grbman/christmas-ornament/hw/reworks.md

## Reworks  
- Install 0 ohm between "south" sides of R7 and R8
- Install 82pF cap at C3 and C4
- Install magnet wire from R18 east pad to R9 north pad
