grbman/christmas-ornament/hw/christmas_ornament.pdf

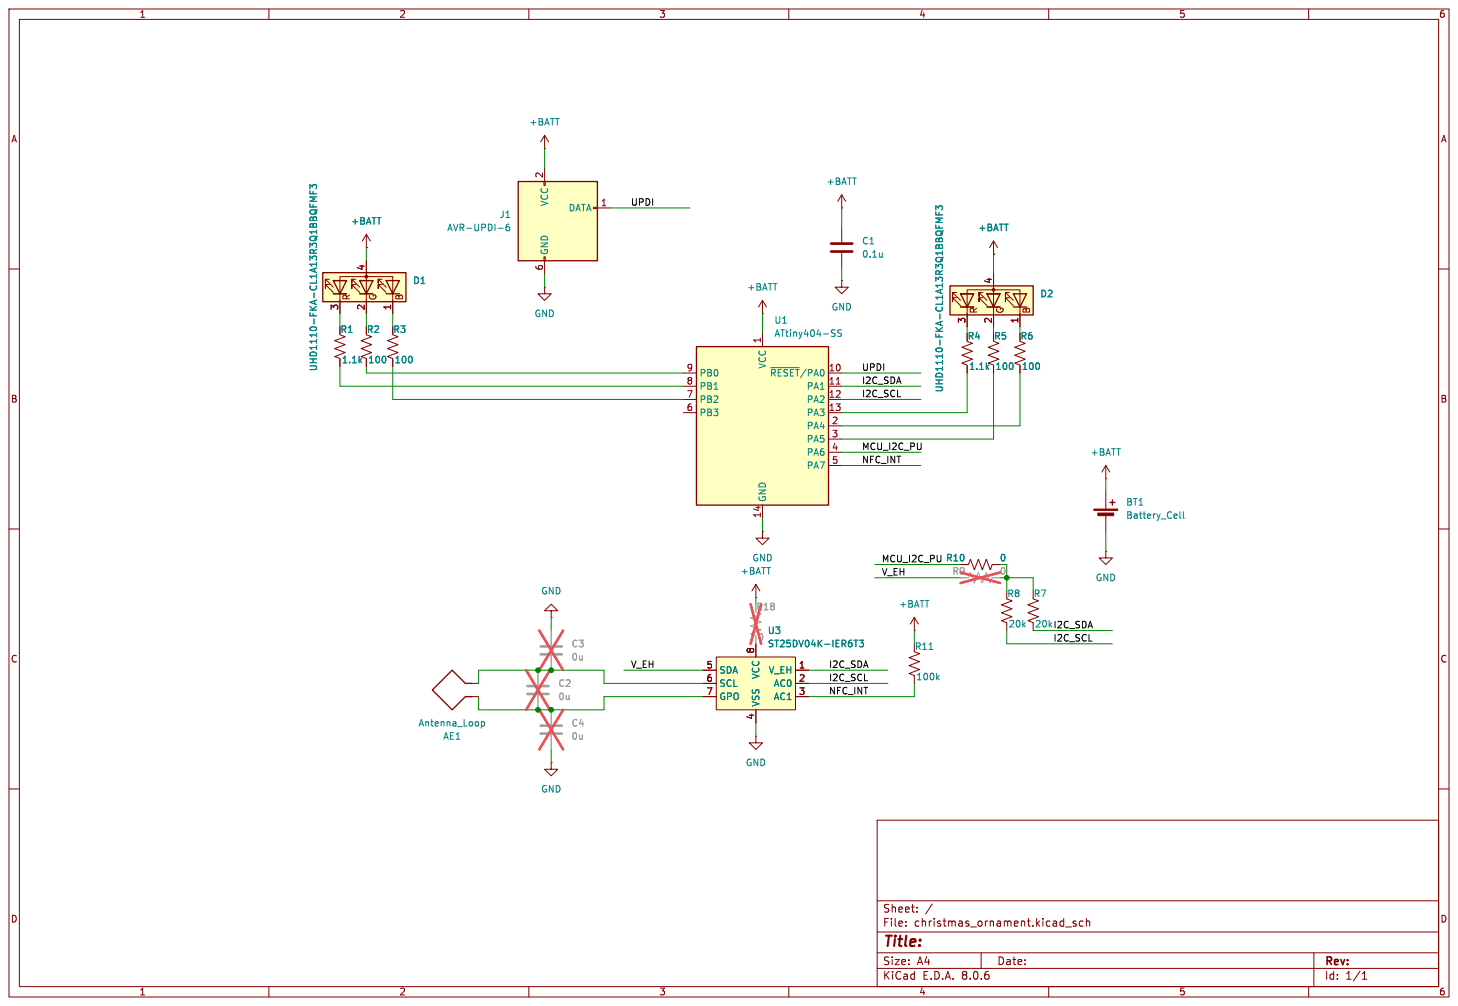
[picture p1: page 1]
