grbman/christmas-ornament/hw/christmas_ornament.kicad_pcb

## KiCad design hw/christmas_ornament.kicad_pcb (2024-11-28)

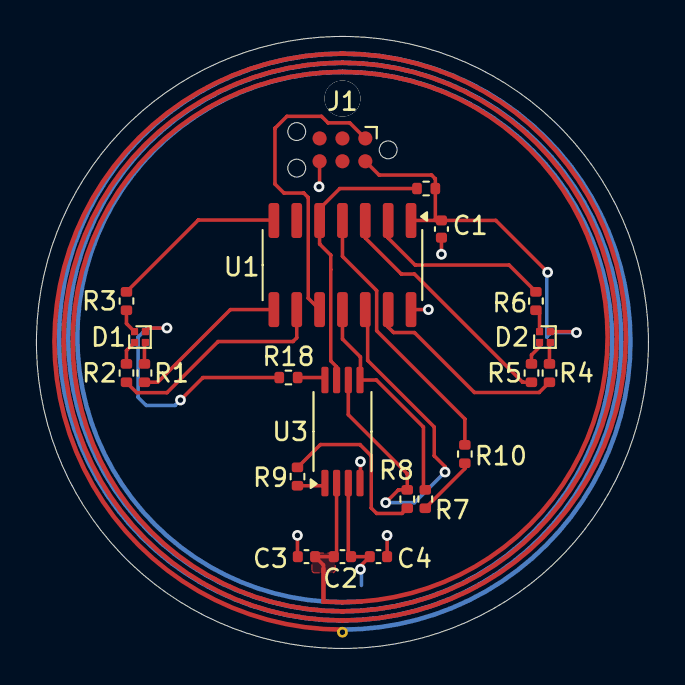
[picture p2: board christmas_ornament.kicad_pcb from above]

Board: 2 copper layers, 34.0 x 34.0 mm, 23 parts (1 on the bottom side), 24 nets.

Parts:
AE1: Antenna_Loop; NFC_coil
BT1: Battery_Cell; BH-67D-5
C1: 0.1u; C_0402_1005Metric
C2, C3, C4: 0u; C_0402_1005Metric
D1, D2: UHD1110-FKA-CL1A13R3Q1BBQFMF3
J1: AVR-UPDI-6; Tag-Connect_TC2030-IDC-NL_2x03_P1.27mm_Vertical
R1, R4: 1.1k; R_0402_1005Metric
R2, R3, R5, R6: 100; R_0402_1005Metric
R7, R8: 20k; R_0402_1005Metric
R9, R10, R18: 0; R_0402_1005Metric
R11: 100k; R_0402_1005Metric
U1: ATtiny404-SS; SOIC-14_3.9x8.7mm_P1.27mm
U3: ST25DV04K-IER8C3; TSSOP-8_4.4x3mm_P0.65mm

Connections:
+BATT: BT1.1 (+), C1.1, D1.4 (A), D2.4 (A), J1.2 (VCC), R11.1, R18.1, U1.1 (VCC)
/I2C_SCL: R8.2, U1.12 (PA2), U3.6 (SCL)
/I2C_SDA: R7.2, U1.11 (PA1), U3.5 (SDA)
/MCU_I2C_PU: R10.1, U1.4 (PA6)
/NFC_INT: R11.2, U1.5 (PA7), U3.7 (GPO)
/UPDI: J1.1 (DATA), U1.10 (~RESET/PA0)
/V_EH: R9.1, U3.1 (V_EH)
GND: BT1.2 (-), C1.2, C3.1, C4.2, J1.6 (GND), U1.14 (GND), U3.4 (VSS)
unnamed: D1.1 (BK), R3.1
unnamed: D1.2 (GK), R2.1
unnamed: D1.3 (RK), R1.1
unnamed: D2.1 (BK), R6.1
unnamed: D2.2 (GK), R5.1
unnamed: D2.3 (RK), R4.1
unnamed: R7.1, R8.1, R9.2, R10.2
unnamed: R4.2, U1.13 (PA3)
unnamed: R6.2, U1.2 (PA4)
unnamed: R5.2, U1.3 (PA5)
unnamed: R2.2, U1.9 (PB0)
unnamed: R1.2, U1.8 (PB1)
unnamed: R3.2, U1.7 (PB2)
unnamed: AE1.1, C2.1, C3.2, U3.2 (AC0)
unnamed: AE1.2, C2.2, C4.1, U3.3 (AC1)
unnamed: R18.2, U3.8 (VCC)
