grbman/christmas-ornament/fw/src/main.c

#define F_CPU 32768
// #include <avr/iotn404.h>
#include <avr/io.h>
#include <util/delay.h>
#include <stdio.h>
#include <avr/interrupt.h>
#include <stddef.h>
#include <stdbool.h>
#include "pindefs.h"
#include "updi_stdio.h"
#include "led.h"
#include "i2c_bitbang.h"
#include "nfc.h"

void (*leds_next)();
volatile bool nfc_write_flag = false;

int main()
{
    // clk setup
    // unlock clock regs
    // use 32768kHz oscillator, no clk output
    CPU_CCP = CCP_IOREG_gc;
    CLKCTRL.MCLKCTRLA = CLKCTRL_CLKSEL_OSCULP32K_gc;
    CPU_CCP = CCP_IOREG_gc;
    CLKCTRL.MCLKCTRLB = 0;

    /* set default GPIO direction to input */
    PORTA.DIR = 0;
    PORTB.DIR = 0;

    /* enable falling edge interrupt */
    PORTA.PIN7CTRL |= PORT_ISC_FALLING_gc;
    PORTA.INTFLAGS |= PORT_INT_7_bm;

    sei(); // Enable global interrupts

    led_init();
    i2c_bitbang_init();
    updi_stdio_init(); // redirect stdin/stdout

    uint8_t count = 0;

    // turn on i2c pullups
    PORTA.DIRSET = (1 << PORTA_I2C_PULLUP_PIN);

    //manually trigger read
    nfc_write_flag = true;  

    // put CPU into idle mode
    SLPCTRL.CTRLA |= SLPCTRL_SMODE_IDLE_gc;

    while (1)
    {
    }
    return 0;
}

volatile bool nfc_write_occurred = false;
volatile uint16_t nfc_write_debounce = 0;

// NFC write interrupt
ISR(PORTA_PORT_vect)
{
    cli();

    PORTA_INTFLAGS |= PORT_INT_7_bm; // Clear the PA0 interrupt flag

    nfc_write_flag = true;

    sei();

    // put CPU into idle mode
    SLPCTRL.CTRLA |= SLPCTRL_SMODE_IDLE_gc;
}

// PWM underflow interrupt
ISR(TCA0_LUNF_vect)
{
    cli();

    TCA0.SPLIT.INTFLAGS |= TCA_SPLIT_LUNF_bm;
    if (nfc_write_flag)
    {
        PORTA.OUTSET = (1 << PORTA_I2C_PULLUP_PIN);
        nfc_write_debounce++;
    }
    // tBoot is 0.6ms
    if (nfc_write_debounce > 32)
    {
        nfc_write_flag = false;
            nfc_write_debounce = 0;
        nfc_write_occurred = true;
    }
    if (nfc_write_occurred)
    {
        nfc_write_occurred = false;
        read_params();
        PORTA.OUTCLR = (1 << PORTA_I2C_PULLUP_PIN);
    }

    // set next LED values
    if(leds_next)
    {
        leds_next();
    }

    sei();
    // put CPU into idle mode
    SLPCTRL.CTRLA |= SLPCTRL_SMODE_IDLE_gc;
}
