grbman/christmas-ornament/fw/inc/updi_uart.h

// ======================================================================
// Virtual UART to be used in combination with upditerm
//
// Copyright 2024 Dick Streefland
//
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
#ifdef __cplusplus
extern "C"
{
#endif

extern	_Bool	updi_uart_enabled	( void );
extern	void	updi_uart_tx		( uint8_t byte );
extern	_Bool	updi_uart_rx_poll	( void );
extern	uint8_t	updi_uart_rx		( void );

#ifdef __cplusplus
}
#endif
